EVERYDAYHERO2000/nartis/enclosure/nartis_print_plate.step

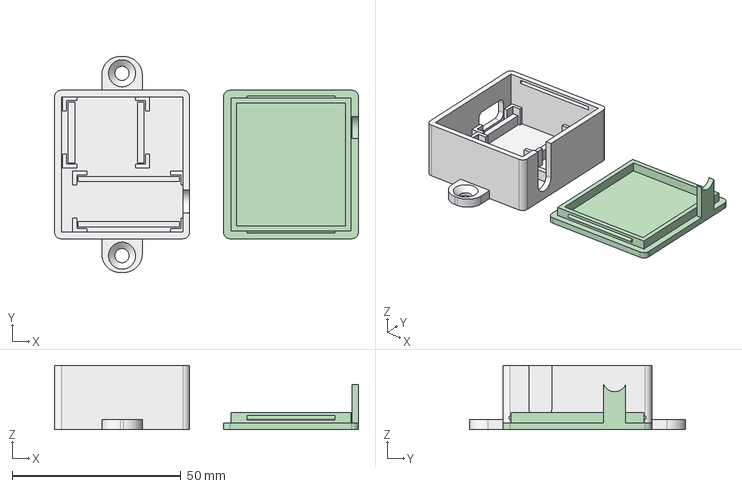
[picture p4: CAD file, 2026-10-13]
enclosure/nartis_print_plate.step
90.0 x 64.0 x 19.0 mm
nartis_box
nartis_lid
