EVERYDAYHERO2000/nartis/(list of files, cad)

Other CAD files:
enclosure/nartis_print_plate.3mf
enclosure/nartis_print_plate.stl
