EVERYDAYHERO2000/nartis/(commit log)

2026-10-12 Nartis RF433 meter reader for ESP32-C3 + CC1101
    ESP-IDF firmware that pairs with a Nartis I100/I300 meter over RF433
    (acting as the D101 remote display), polls it via DLMS/COSEM and exposes
    the readings in a web UI and a REST API for Home Assistant and others.
    - radio stack ported from FerrumLogic/esphome-nartis-rf-meter-cc1101
    (based on latonita/esphome-nartis-rf-meter) with a thin ESPHome shim
    - Wi-Fi setup via nartis-setup access point with captive portal
    - settings (Wi-Fi, meter serial, channel, interval) stored in NVS
    - TX power limited to 8.5 dBm for ESP32-C3 Super Mini boards
    [partitions.csv]
2026-10-12 Add Home Assistant integration
    Custom integration (custom_components/nartis) that polls the device's
    local REST API and exposes one Nartis device in Home Assistant:
    - config flow by host/IP with connection check, options for poll interval
    - sensors: power, voltage and current per phase, energy total and per
    tariff (total_increasing, Energy dashboard ready), frequency
    - diagnostics: pairing state, last meter reading time, Wi-Fi RSSI
    - unknown OBIS values from the firmware become generic sensors
    - English and Russian translations, HACS metadata
    - README: installation via HACS or manual copy, YAML REST alternative
2026-10-13 Reject meter replies that belong to another read batch
    The meter sometimes re-hands the previous batch's response with a fresh
    nested counter. With equal batch sizes it passed the replay and count
    guards and stored e.g. voltages into the energy/tariff sensors, so the
    kWh readings dropped to values like 2.2.
    Check each attribute's DLMS type against the type expected for that
    sensor (seeded from DEFS, learned from accepted replies, reset when a
    batch is skipped) and drop mismatching replies so the batch re-sends.
    [meter.cpp, nartis_rf_meter.cpp, nartis_rf_meter.h]
2026-10-13 Treat a 0x43 reply to the wake beacon as ack
    After an interrupted read cycle the meter answers every wake beacon with
    its still-pending data reply (0x43) instead of 0x40, so the component
    re-sent the beacon until it gave up and the whole cycle failed. The close
    path already treats this re-delivery as the final ack; do the same on
    wake. Stale data is filtered by the replay and DLMS type guards.
    [nartis_rf_meter.cpp]
2026-10-13 Add 3D-printable wall-mount enclosure
    Parametric CadQuery model (enclosure/enclosure.py) for the ESP32-C3 Super
    Mini + E07-M1101D build:
    - wall mount with two countersunk screw ears, SMA through a U-slot in the
    top end (closed by a tongue on the lid), USB-C opening in the bottom end
    - boards on supports with corner guides, snap-fit lid, no supports needed
    - print plate with both parts as a 3MF (two separate objects), STL and STEP
    - README section with print settings and the dimensions to verify
    [nartis_print_plate.3mf, nartis_print_plate.step, nartis_print_plate.stl]
2026-10-14 Release v1.1.0: fix read batch guards and add phase power dashboard
    [nartis_rf_meter.cpp, nartis_rf_meter.h, web.c]
2026-10-15 Firmware 1.1.1: allow 10 data polls per read batch
    On a Nartis I300 the first batch's data arrived about 0.5 s after the 6th
    req-beacon poll, so the batch was skipped every cycle (power, voltages and
    L1 current did not update) and its late reply had to be rejected by the
    type guard. Raise MAX_RETRIES_ from 6 to 10.
    [nartis_rf_meter.h]
2026-10-15 Add Home Assistant integration icon
    Brand images in custom_components/nartis/brand (icon, icon@2x and dark
    variants, 256/512 px, transparent): a meter dial with a bolt and radio
    waves, using the web UI accent colour. Home Assistant serves them from the
    integration folder (checked on 2026.10). SVG source in docs/images.
